reedb/bc29/README.md

Generate a schematic for the Brusa BC29 Ampere hour meter in CADSOFT Eagle format.
