reedb/bc29/4053_pin2.bmp

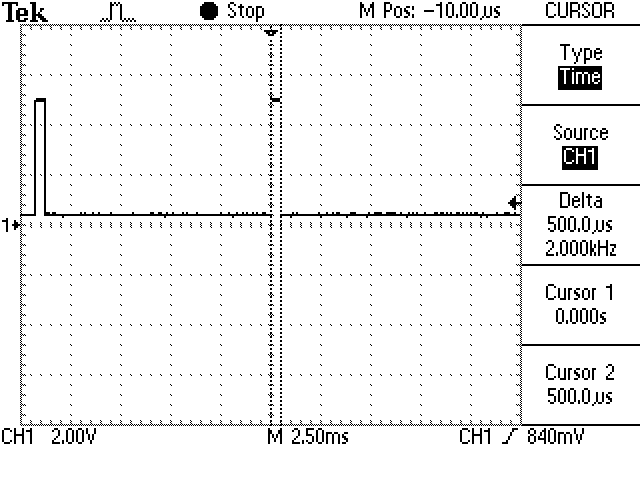
4053_pin2.bmp
