reedb/bc29/bc29.png

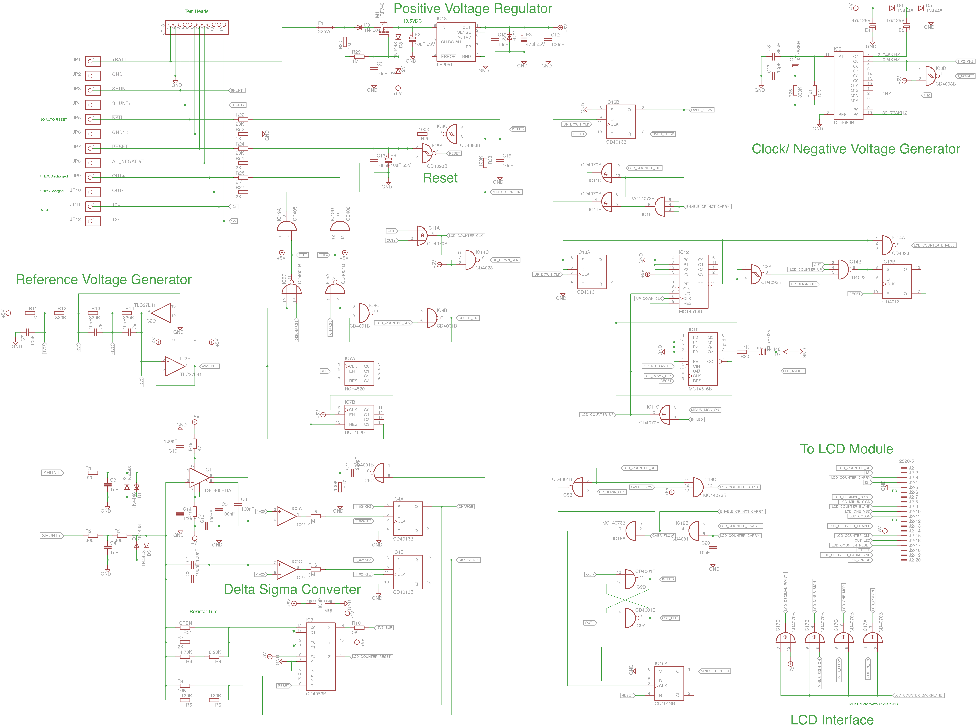
bc29.png
