reedb/bc29/bc29_anz_a.png

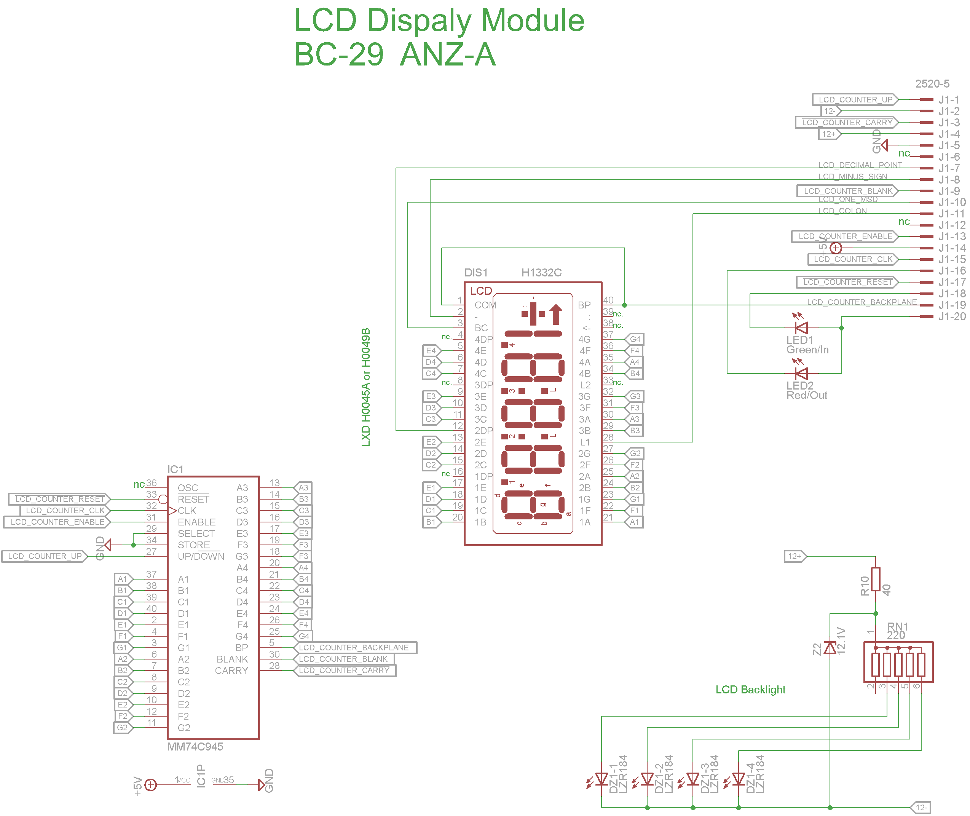
bc29_anz_a.png
