reedb/bc29/bc29_ss.png

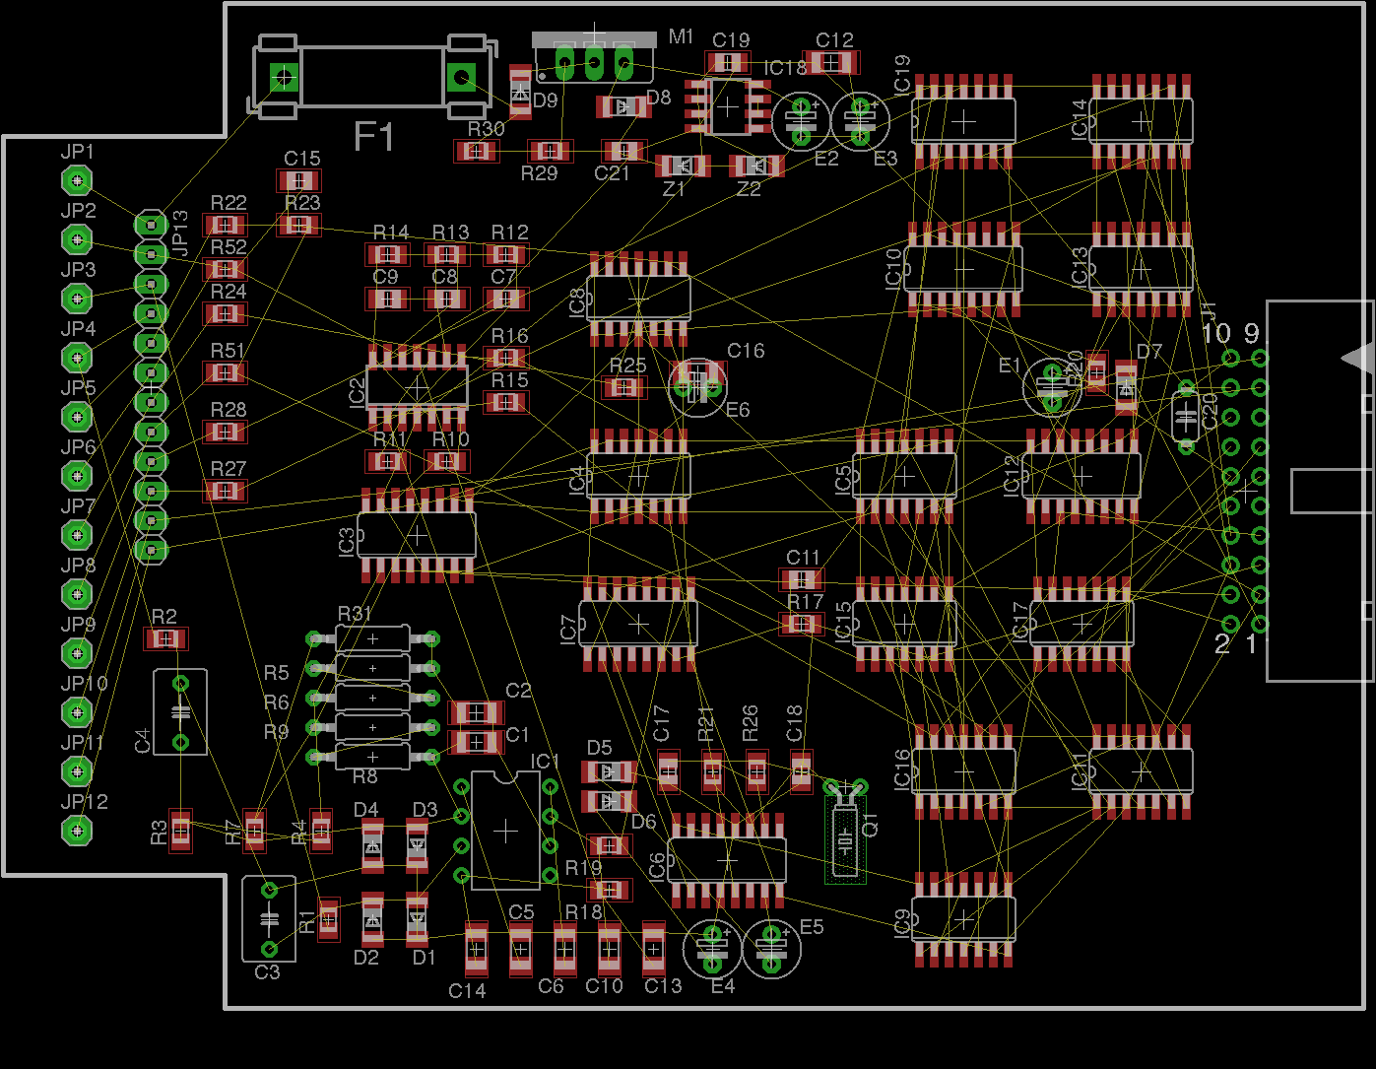
bc29_ss.png
