reedb/bc29/CD4060_pin7.bmp

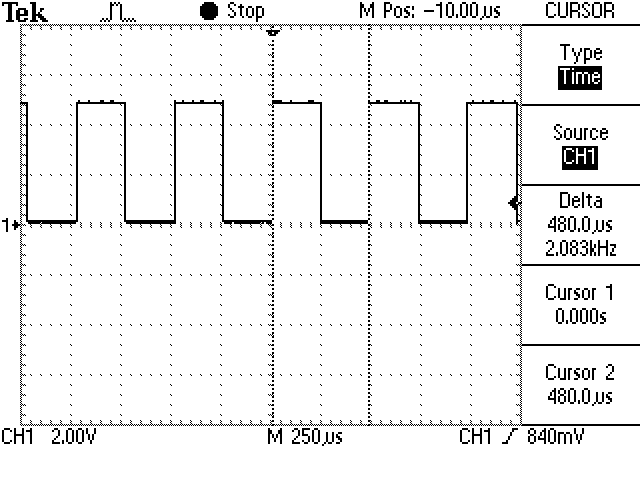
CD4060_pin7.bmp
