reedb/bc29/CD4060_pin10.bmp

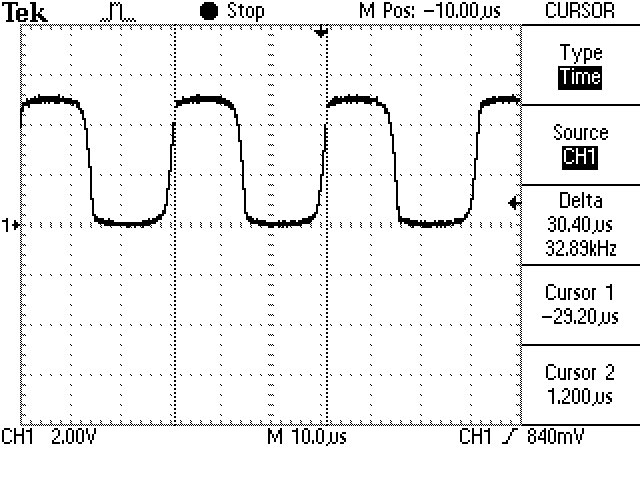
CD4060_pin10.bmp
