reedb/bc29/TSC900BIJA_pin6.bmp

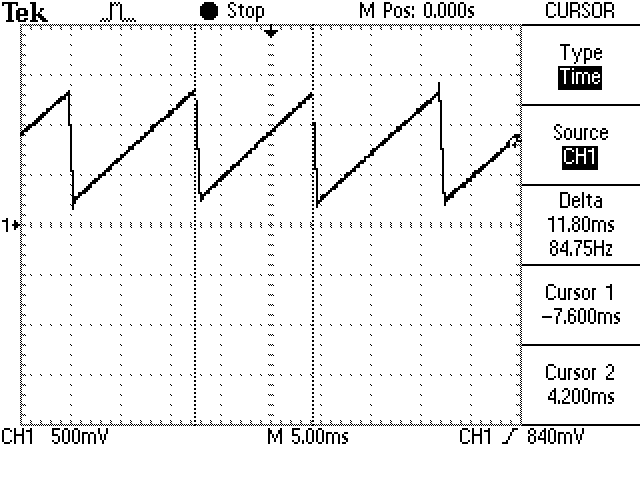
TSC900BIJA_pin6.bmp
