reedb/bc29/bc29.brd

## EAGLE design bc29.brd (2015-01-09)

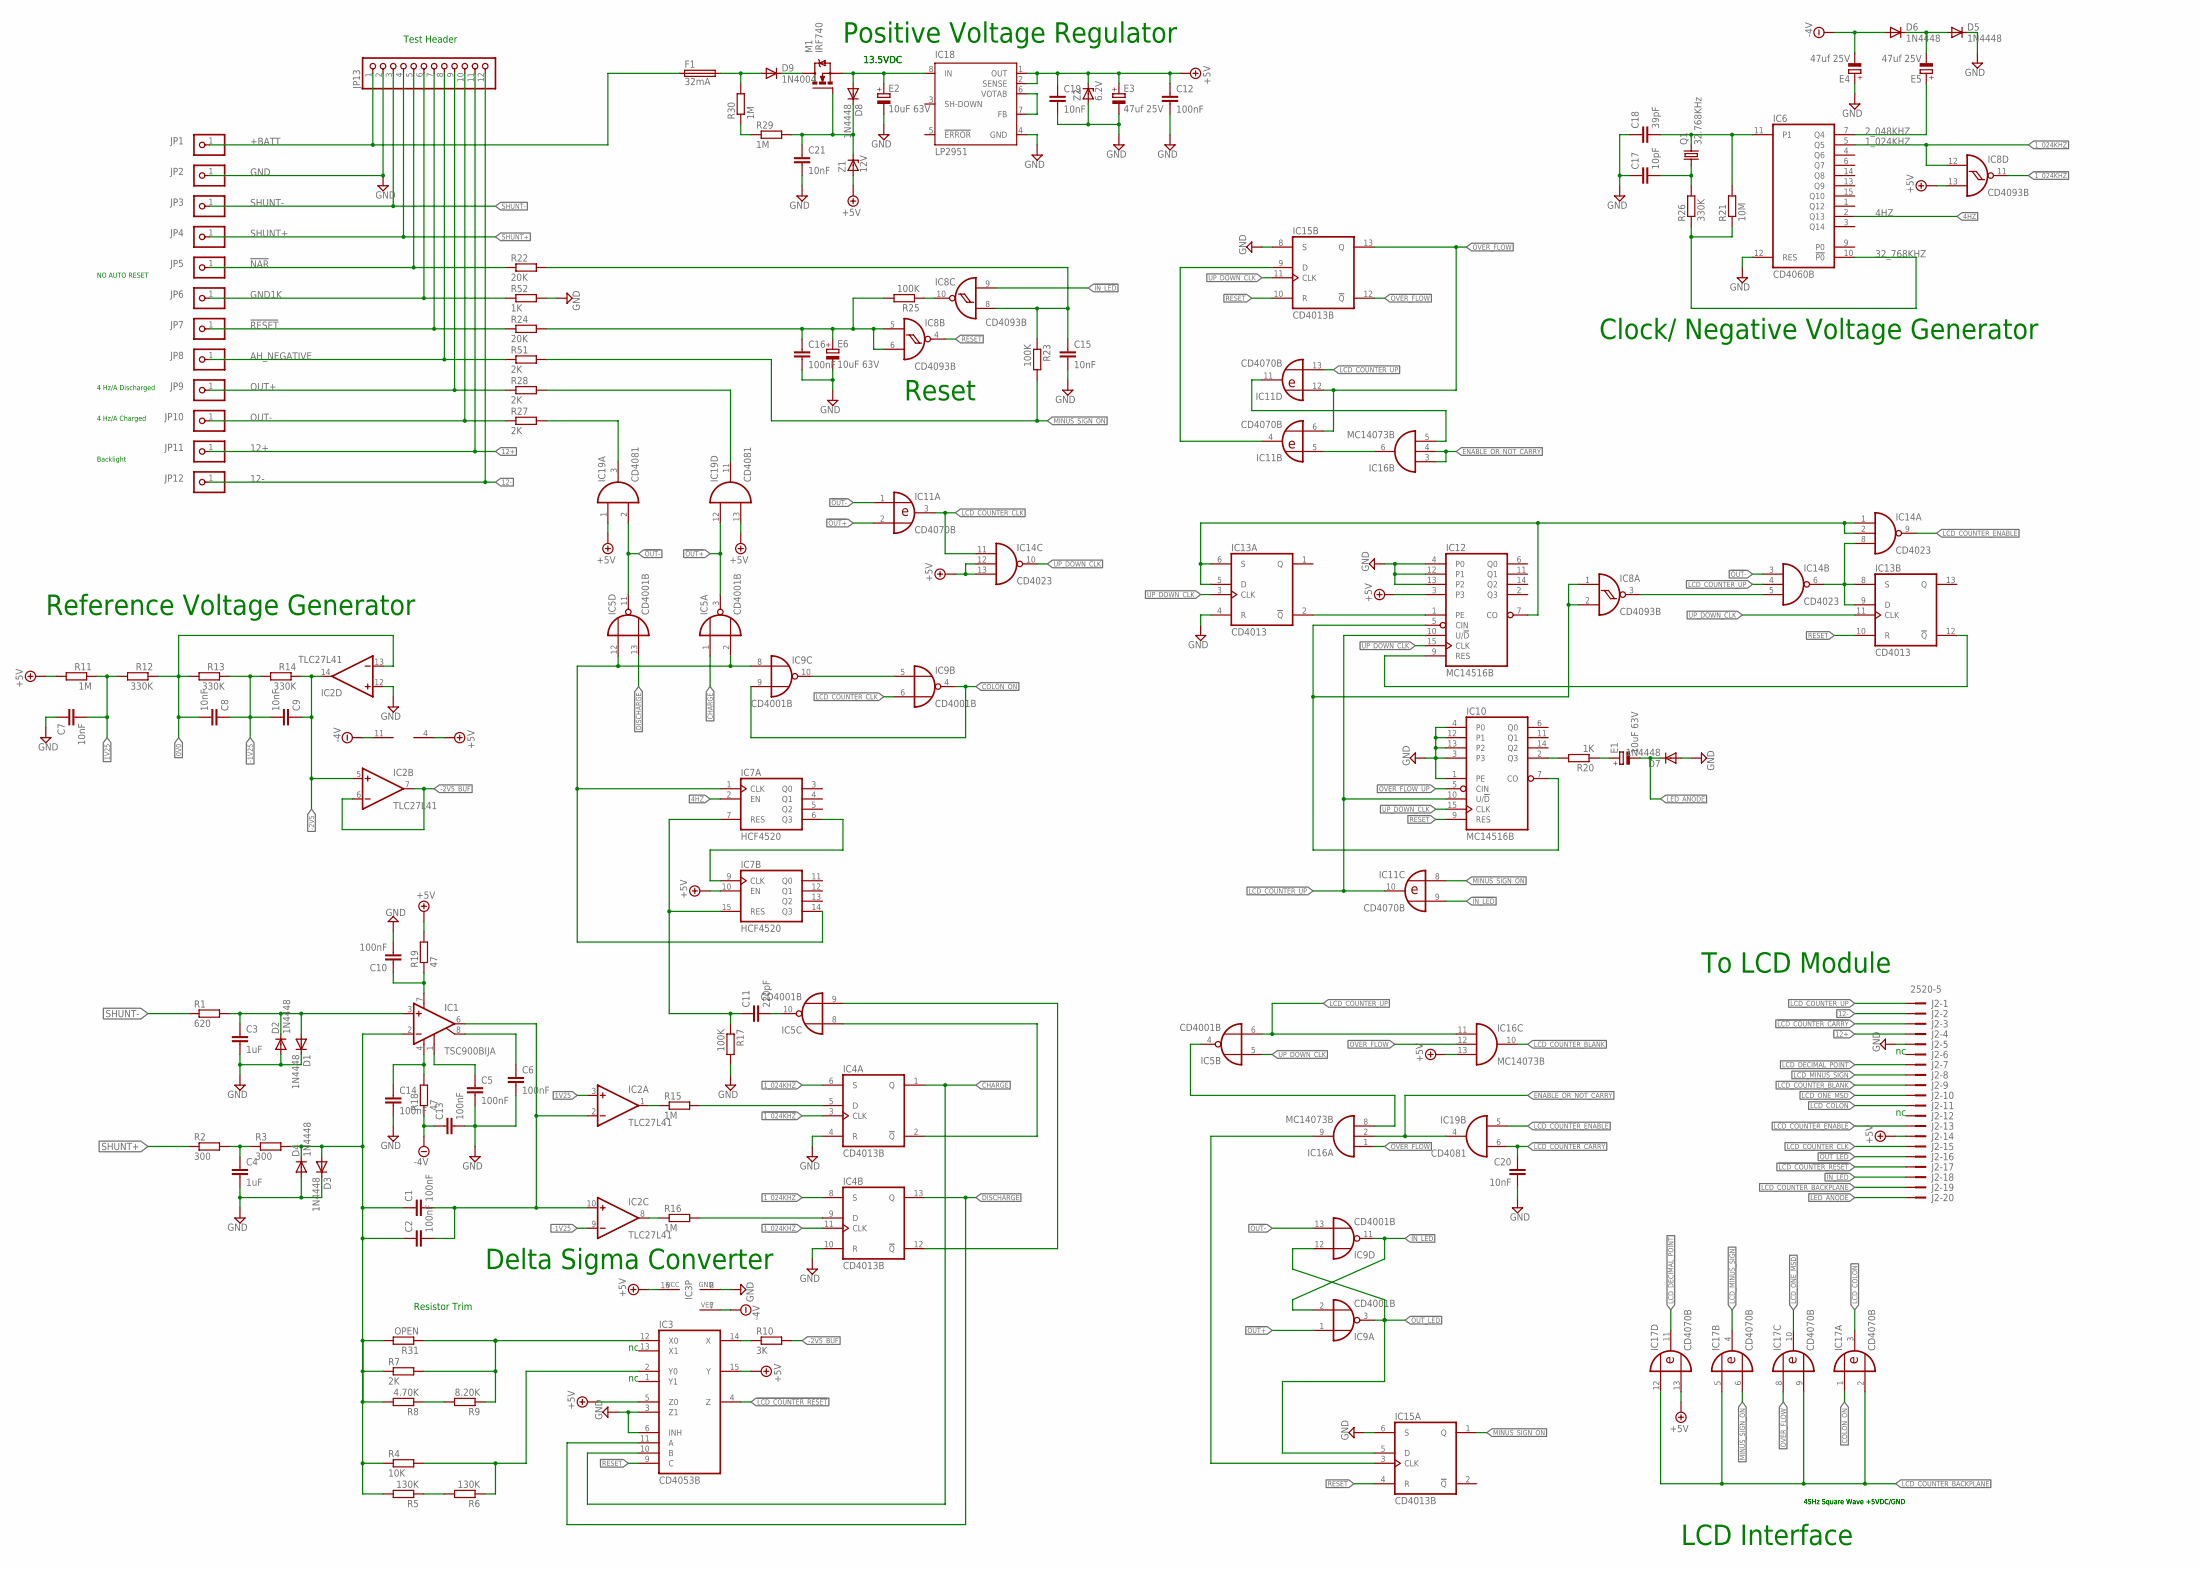
[picture p8: schematic bc29.sch]

Parts:
C1, C2, C5, C6, C10, C12, C13, C14, C16: 100nF; C1206
C3, C4: 1uF; C050-045X075
C7, C8, C9, C15, C19, C21: 10nF; C0805
C11: 220pF; C0805
C17: 10pF; C0805
C18: 39pF; C0805
C20: 10nF; C050-024X044
D1, D2, D3, D4, D5, D6, D7, D8: 1N4448; MINIMELF
D9: 1N4004; SOD80C
E1, E2, E6: 10uF 63V; E2,5-5
E3, E4, E5: 47uf 25V; E2,5-5
F1: 32mA; FUSE_HOLDER_5X20MM
IC1: TSC900BIJA; DIL08
IC2: TLC27L41; SO14
IC3: CD4053B; SO16
IC4, IC15: CD4013B; SO14
IC5, IC9: CD4001B; SO14
IC6: CD4060B; SO16
IC7: HCF4520; SO16
IC8: CD4093B; SO14
IC10, IC12: MC14516B; SO16
IC11, IC17: CD4070B; SO14
IC13: CD4013; SO14
IC14: CD4023; SO14
IC16: MC14073B; SO14
IC18: LP2951; SO08
IC19: CD4081; SO14
J2: 2520-5; PAK100/2500-5-20
JP1, JP2, JP3, JP4, JP5, JP6, JP7, JP8, JP9, JP10, JP11, JP12: PINHD-1X1; 1X01
JP13: PINHD-1X12; 1X12
M1: IRF740; TO220BV
Q1: 32.768KHz; TC26H
R1: 620; M0805
R2, R3: 300; M0805
R4: 10K; M0805
R5, R6: 130K; 0207/10
R7, R27, R28, R51: 2K; M0805
R8: 4.70K; 0207/10
R9: 8.20K; 0207/10
R10: 3K; M0805
R11, R15, R16, R29, R30: 1M; M0805
R12, R13, R14, R26: 330K; M0805
R17, R23, R25: 100K; M0805
R18, R19: 47; M0805
R20, R52: 1K; M0805
R21: 10M; M0805
R22, R24: 20K; M0805
R31: OPEN; 0207/10
Z1: 12V; SOD80C
Z2: 6.2V; SOD80C

Connections:
0V0: C8.2, IC2.13 (-IN), R12.1, R13.2
1V25: C7.2, IC2.3 (+IN), R11.1, R12.2
1_024KHZ: IC4.6 (S), IC4.8 (S), IC6.5 (Q5), IC8.12 (I0)
2_048KHZ: E5.+, IC6.7 (Q4)
4HZ: IC6.2 (Q13), IC7.2 (EN)
12+: J2.4, JP11.1, JP13.11
12-: J2.2, JP12.1, JP13.12
13V5: D8.A, E2.+, IC18.8 (IN), M1.S
32_768KHZ: IC6.10 (!P0), R21.1, R26.1
!1_024KHZ: IC4.3 (CLK), IC4.11 (CLK), IC8.11 (O)
!CHARGE: IC4.2 (!Q), IC5.8 (I0)
!DISCHARGE: IC4.12 (!Q), IC5.9 (I1)
!IN_LED: IC8.9 (I1), IC9.2 (I1), IC9.11 (O), IC11.9 (I1), J2.18
!LCD_COUNTER_CARRY: C20.1, IC19.6 (I1), J2.3
!LCD_COUNTER_RESET: IC3.4 (Z), J2.17
!NAR: JP5.1, JP13.5, R22.1
!NAR_R: C15.1, IC8.8 (I0), R22.2, R23.1
!OUT+: IC5.3 (O), IC9.1 (I0), IC11.2 (I1), IC19.12 (I0)
!OUT-: IC5.11 (O), IC9.13 (I1), IC11.1 (I0), IC14.3 (I0), IC19.2 (I1)
!OUT_LED: IC9.3 (O), IC9.12 (I0), IC15.5 (D), J2.16
!OVER_FLOW: IC15.12 (!Q), IC16.1 (I0)
!RESET: JP7.1, JP13.7, R24.1
+5V: C12.1, C19.1, E3.+, IC2.4 (V+), IC3.5 (Z0), IC3.15 (Y), IC3.16 (VCC), IC7.10 (EN), IC8.13 (I1), IC12.3, IC14.12 (I1), IC14.13 (I2), IC16.13 (I2), IC17.13 (I1), IC18.1 (OUT), IC18.2 (SENSE), IC19.1 (I0), IC19.13 (I1), J2.14, R11.2, R19.2, Z1.A, Z2.C
+BATT: F1.1, JP1.1, JP13.1
-1V25: C8.1, C9.2, IC2.9 (-IN), R13.1, R14.2
-2V5: C9.1, IC2.5 (+IN), IC2.14 (OUT), R14.1
-2V5_BUF: IC2.6 (-IN), IC2.7 (OUT), R10.2
-2V5_BUF_R: IC3.14 (X), R10.1
-4V: D6.A, E4.-
-5V: C13.1, IC2.11 (V-), IC3.7 (VEE), R18.1
AH_NEGATIVE: JP8.1, JP13.8, R51.1
CHARGE: IC3.10 (B), IC4.1 (Q), IC5.1 (I0)
COLON_ON: IC9.4 (O), IC9.9 (I1), IC17.1 (I0)
CXA: C5.1, IC1.1 (CMP1)
CXB: C6.1, IC1.8 (CMP2)
DISCHARGE: IC3.11 (A), IC4.13 (Q), IC5.13 (I1)
DRAIN: D9.C, M1.D
D_CHARGE: IC4.5 (D), R15.2
D_DISCHARGE: IC4.9 (D), R16.2
ENABLE_OR_NOT_CARRY: IC16.2 (I1), IC16.3 (I0), IC16.4 (I1), IC19.4 (O)
FUSED_BATT+: D9.A, F1.2, R30.2
GATE: C21.1, D8.C, M1.G, R29.2, Z1.C
GND: C3.2, C4.2, C5.2, C6.2, C7.1, C10.2, C12.2, C13.2, C14.2, C15.2, C16.2, C17.1, C18.1, C19.2, C20.2, C21.2, D1.C, D2.A, D3.C, D4.A, D5.C, D7.A, E2.-, E3.-, E4.+, E6.-, IC2.12 (+IN), IC3.3 (Z1), IC3.6 (INH), IC3.8 (GND), IC4.4 (R), IC4.10 (R), IC6.12 (RES), IC10.1 (PE), IC10.3, IC10.4 (P0), IC10.12 (P1), IC10.13 (P2), IC12.4 (P0), IC12.12 (P1), IC12.13 (P2), IC13.4 (R), IC15.6 (S), IC15.8 (S), IC18.4 (GND), J2.5, JP2.1, JP13.2, R17.2, R52.2, Z2.A
GND1K: JP6.1, JP13.6, R52.1
IC3-11: IC11.11 (O), IC16.5 (I2)
IC5-4: IC5.4 (O), IC16.8 (I2)
IC7-14: IC5.2 (I1), IC5.12 (I0), IC7.1 (CLK), IC7.14 (Q3), IC9.8 (I0)
IC8-3: IC8.3 (O), IC14.5 (I2)
IC10-7: IC8.1 (I0), IC8.2 (I1), IC10.7 (CO), IC12.5 (CIN)
IC13-5: IC12.7 (CO), IC13.5 (D), IC13.6 (S), IC14.1 (I0), IC14.2 (I1)
IC14-6: IC13.8 (S), IC13.9 (D), IC14.6 (O), IC14.8 (I2)
IC15-3: IC15.3 (CLK), IC16.9 (O)
IN+: C3.1, D1.A, D2.C, IC1.3 (+IN), R1.2
IN-: C1.1, C2.1, D3.A, D4.C, IC1.2 (-IN), R3.2, R4.1, R5.2, R7.1, R8.2, R31.2
LCD_COLON: IC17.3 (O), J2.11
LCD_COUNTER_BACKPLANE: IC17.2 (I1), IC17.5 (I0), IC17.9 (I1), IC17.12 (I0), J2.19
LCD_COUNTER_BLANK: IC16.10 (O), J2.9
LCD_COUNTER_CLK: IC9.6 (I1), IC11.3 (O), IC14.11 (I0), J2.15
LCD_COUNTER_ENABLE: IC14.9 (O), IC19.5 (I0), J2.13
LCD_COUNTER_UP: IC5.6 (I1), IC10.10 (U/!D), IC11.10 (O), IC11.13 (I1), IC12.10 (U/!D), IC14.4 (I1), IC16.11 (I0), J2.1
LCD_DECIMAL_POINT: IC17.11 (O), J2.7
LCD_MINUS_SIGN: IC17.4 (O), J2.8
LCD_ONE_MSD: IC17.10 (O), J2.10
LED_ANODE: D7.C, E1.-, J2.20
MINUS_SIGN_ON: IC11.8 (I0), IC15.1 (Q), IC17.6 (I1), R23.2, R51.2
unnamed: C11.2, IC5.10 (O)
unnamed: IC12.9 (RES), IC13.12 (!Q)
unnamed: IC11.4 (O), IC15.9 (D)
unnamed: IC12.1 (PE), IC13.2 (!Q)
unnamed: IC7.6 (Q3), IC7.9 (CLK)
unnamed: C11.1, IC7.7 (RES), IC7.15 (RES), R17.1
unnamed: IC9.5 (I0), IC9.10 (O)
unnamed: IC11.5 (I0), IC16.6 (O)
unnamed: R29.1, R30.1
unnamed: IC10.2 (Q3), R20.2
unnamed: D5.A, D6.C, E5.-
unnamed: C17.2, Q1.1, R26.2
unnamed: C18.2, IC6.11 (P1), Q1.2, R21.2
unnamed: R5.1, R6.2
unnamed: IC18.6 (VOTAB), IC18.7 (FB)
unnamed: R8.1, R9.2
unnamed: IC8.10 (O), R25.1
unnamed: E1.+, R20.1
NEG_COMPARATOR: IC2.8 (OUT), R16.1
OP_AMP__OUT: C1.2, C2.2, IC1.6 (OUT), IC2.2 (-IN), IC2.10 (+IN)
OUT+: JP9.1, JP13.9, R28.1
OUT+_R: IC19.11 (O), R28.2
OUT-: JP10.1, JP13.10, R27.1
OUT-_R: IC19.3 (O), R27.2
OVER_FLOW: IC11.6 (I1), IC11.12 (I0), IC15.13 (Q), IC16.12 (I1), IC17.8 (I0)
OVER_FLOW_UP: IC10.5 (CIN)
POS_COMPARATOR: IC2.1 (OUT), R15.1
RESET: IC3.9 (C), IC8.4 (O), IC10.9 (RES), IC13.10 (R), IC15.4 (R), IC15.10 (R)
RESET_R: C16.1, E6.+, IC8.5 (I0), IC8.6 (I1), R24.2, R25.2
SHUNT+: JP4.1, JP13.4, R2.1
SHUNT+FILTER: C4.1, R2.2, R3.1
SHUNT-: JP3.1, JP13.3, R1.1
UP_DOWN_CLK: IC5.5 (I0), IC10.15 (CLK), IC12.15 (CLK), IC13.3 (CLK), IC13.11 (CLK), IC14.10 (O), IC15.11 (CLK)
VDD: IC4.14 (VDD), IC5.14 (VDD), IC6.16 (VDD), IC7.16 (VDD), IC8.14 (VDD), IC9.14 (VDD), IC10.16 (VDD), IC11.14 (VDD), IC12.16 (VDD), IC13.14 (VDD), IC14.14 (VDD), IC15.14 (VDD), IC16.14 (VDD), IC17.14 (VDD), IC19.14 (VDD)
VDD+: C10.1, IC1.7 (V+), R19.1
VDD-: C14.1, IC1.4 (V-), R18.2
VSS: IC4.7 (VSS), IC5.7 (VSS), IC6.8 (VSS), IC7.8 (VSS), IC8.7 (VSS), IC9.7 (VSS), IC10.8 (VSS), IC11.7 (VSS), IC12.8 (VSS), IC13.7 (VSS), IC14.7 (VSS), IC15.7 (VSS), IC16.7 (VSS), IC17.7 (VSS), IC19.7 (VSS)
X0: IC3.12 (X0), R7.2, R9.1, R31.1
Y0: IC3.2 (Y0), R4.2, R6.1

Notes on the sheet:
Test Header
13.5VDC
Resistor Trim
Delta Sigma Converter
NO AUTO RESET
4 Hz/A Discharged
4 Hz/A Charged
Backlight
Reference Voltage Generator
LCD Interface
Clock/ Negative Voltage Generator
Positive Voltage Regulator
To LCD Module
45Hz Square Wave +5VDC/GND
Reset

Board: 2 copper layers, 107 parts (0 on the bottom side), 103 nets, no tracks yet.
