reedb/bc29/bc29_anz_a.brd

## EAGLE design bc29_anz_a.brd (2014-12-25)

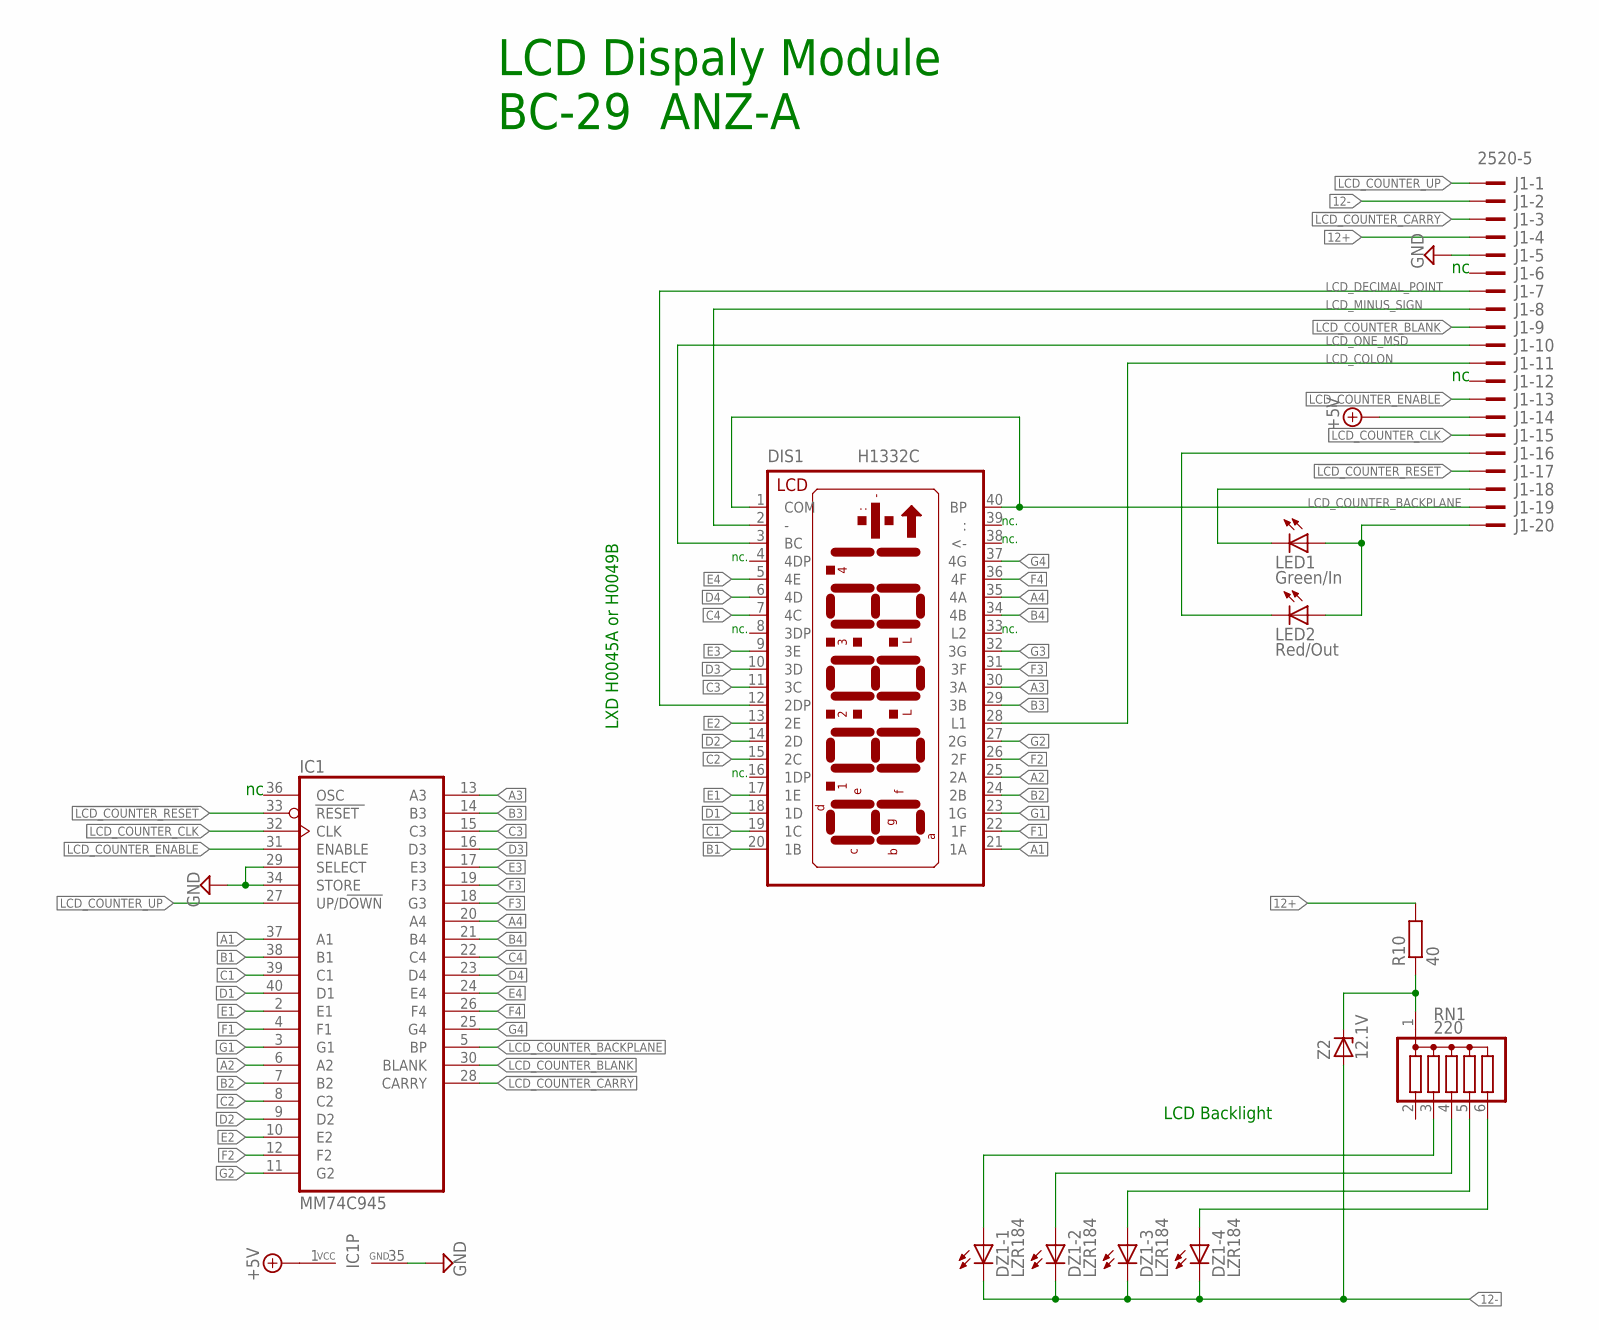
[picture p9: schematic bc29_anz_a.sch]

Parts:
DIS1: H1332C
DZ1: LZR184
IC1: MM74C945; DIL40
J1: 2520-5; PAK100/2500-5-20
LED1: Green/In; LED5MM
LED2: Red/Out; LED5MM
R10: 40; 0207/10
RN1: 220; SIL6
Z2: 12.1V; SOD80C

Connections:
12+: J1.4, R10.2
12-: DZ1.K1 (C), DZ1.K2 (C), DZ1.K3 (C), DZ1.K4 (C), J1.2, Z2.A
!IN_LED: J1.18, LED1.K (C)
!LCD_COUNTER_CARRY: IC1.28 (CARRY), J1.3
!LCD_COUNTER_RESET: IC1.33 (RESET), J1.17
!OUT_LED: J1.16, LED2.K (C)
+5V: J1.14
+12V: IC1.1 (VCC)
A1: DIS1.21 (1A), IC1.37 (A1)
A2: DIS1.25 (2A), IC1.6 (A2)
A3: DIS1.30 (3A), IC1.13 (A3)
A4: DIS1.35 (4A), IC1.20 (A4)
B1: DIS1.20 (1B), IC1.38 (B1)
B2: DIS1.24 (2B), IC1.7 (B2)
B3: DIS1.29 (3B), IC1.14 (B3)
B4: DIS1.34 (4B), IC1.21 (B4)
BL0: DZ1.A1 (A), RN1.3
BL1: DZ1.A2 (A), RN1.4
BL2: DZ1.A3 (A), RN1.5
BL3: DZ1.A4 (A), RN1.6
C1: DIS1.19 (1C), IC1.39 (C1)
C2: DIS1.15 (2C), IC1.8 (C2)
C3: DIS1.11 (3C), IC1.15 (C3)
C4: DIS1.7 (4C), IC1.22 (C4)
D1: DIS1.18 (1D), IC1.40 (D1)
D2: DIS1.14 (2D), IC1.9 (D2)
D3: DIS1.10 (3D), IC1.16 (D3)
D4: DIS1.6 (4D), IC1.23 (D4)
E1: DIS1.17 (1E), IC1.2 (E1)
E2: DIS1.13 (2E), IC1.10 (E2)
E3: DIS1.9 (3E), IC1.17 (E3)
E4: DIS1.5 (4E), IC1.24 (E4)
F1: DIS1.22 (1F), IC1.4 (F1)
F2: DIS1.26 (2F), IC1.12 (F2)
F3: DIS1.31 (3F), IC1.19 (F3)
F4: DIS1.36 (4F), IC1.26 (F4)
G1: DIS1.23 (1G), IC1.3 (G1)
G2: DIS1.27 (2G), IC1.11 (G2)
G3: DIS1.32 (3G), IC1.18 (G3)
G4: DIS1.37 (4G), IC1.25 (G4)
GND: IC1.29 (SELECT), IC1.34 (STORE), IC1.35 (GND), J1.5
LCD_COLON: DIS1.28 (L1), J1.11
LCD_COUNTER_BACKPLANE: DIS1.1 (COM), DIS1.40 (BP), IC1.5 (BP), J1.19
LCD_COUNTER_BLANK: IC1.30 (BLANK), J1.9
LCD_COUNTER_CLK: IC1.32 (CLK), J1.15
LCD_COUNTER_ENABLE: IC1.31 (ENABLE), J1.13
LCD_COUNTER_UP: IC1.27 (UP/DOWN), J1.1
LCD_DECIMAL_POINT: DIS1.12 (2DP), J1.7
LCD_MINUS_SIGN: DIS1.2 (-), J1.8
LCD_ONE_MSD: DIS1.3 (BC), J1.10
LED_ANODE: J1.20, LED1.A, LED2.A
LED_V+: R10.1, RN1.1, Z2.C

Notes on the sheet:
LCD Dispaly Module
BC-29 ANZ-A
LXD H0045A or H0049B
LCD Backlight
nc.

Board: 2 copper layers, 9 parts (0 on the bottom side), 50 nets, no tracks yet.
