reedb/bc29/(commit log)

2014-12-02 Complete board silk screen. Update schematic to match
    [bc29.brd, bc29.sch]
2014-12-02 Charge/discharge output
    [bc29.brd, bc29.sch]
2014-12-03 more charge/discharge
    [bc29.brd, bc29.sch]
2014-12-04 Digital updates
    [bc29.brd, bc29.sch]
2014-12-05 cleanup up/down counter
    [bc29.brd, bc29.sch]
2014-12-06 cleanup random gates
    [bc29.brd, bc29.sch]
2014-12-08 Change reference designators and capacitor values to match 'Official' schematic
    [bc29.brd, bc29.sch]
2014-12-12 add last capacitor values
2014-12-12 update lcd interface portion
    [bc29.brd, bc29.sch]
2014-12-19 Add display module
    [bc29_anz_a.brd, bc29_anz_a.sch]
2014-12-19 Incorperate display module knowldge
    [bc29.brd, bc29.sch, bc29_anz_a.brd, bc29_anz_a.sch]
2014-12-20 Move things around. Update png files
    [bc29.brd, bc29.sch]
2014-12-25 Clean up net names
    [bc29.brd, bc29.sch, bc29_anz_a.brd, bc29_anz_a.sch]
2014-12-27 Clean up some net names
    [bc29.brd, bc29.sch]
2015-01-09 Rference files on Yahoo Solectria_EV site
    [bc29.brd, bc29.sch]
